retrocityransom/fami-fighter/media/photos/turbobox_presentation_small.jpg

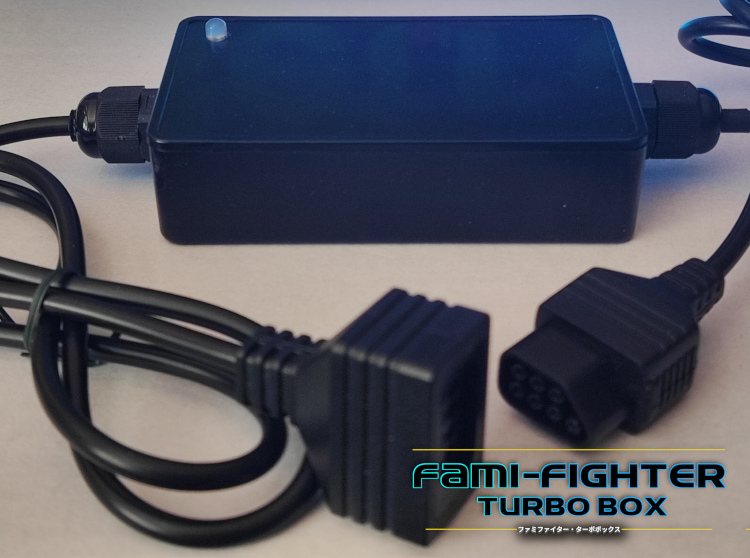
media/photos/turbobox_presentation_small.jpg
