retrocityransom/fami-fighter/files/Fami-Fighter_flashing_instructions_for_Arduino.pdf

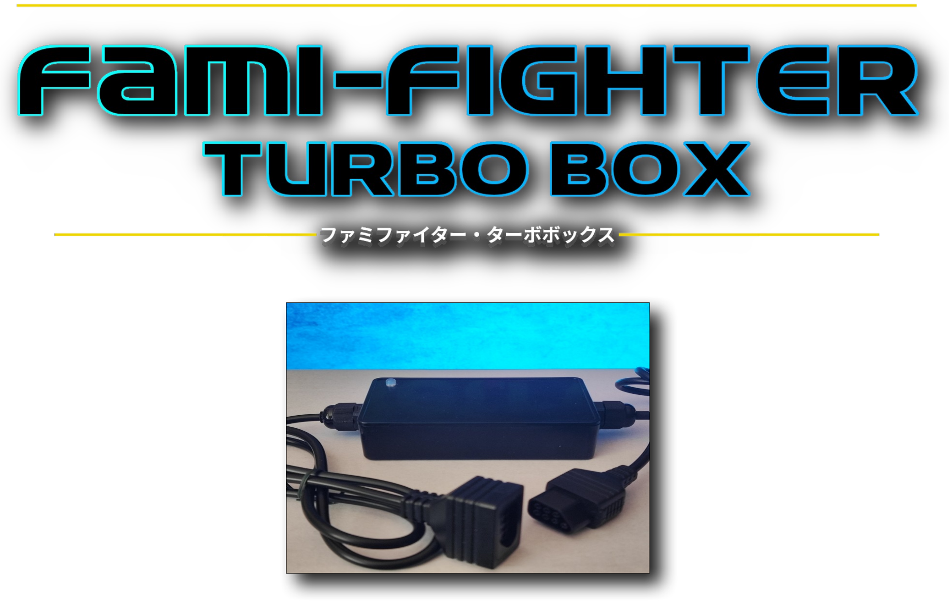
[picture p45: figure]

# Flashing Instructions for Arduino ver. 20260818

# Prerequisites

## - Download the code from https://github.com/retrocityransom/fami-fighter. (https://github.com/retrocityransom/fami-fighter)

## - Download and install the Arduino IDE from https://github.com/ard

uino/arduino-ide/releases/. (https://github.com/arduino/arduino-ide/releases/) It is free.

## - Get a USB-to-TTL adapter for the Arduino Pro Mini. It must support 5 V operation. The examples in this guide use an IDUINO

FT232.

## - Important: It is best to flash the code to the Arduino before installing it in the Turbo Box. However, you can flash updates or changes afterwards without any issues. Just make sure to disconnect your Turbo Box from your game console before

connecting it to the USB-to-TTL adapter.

# Step 1

Open the .ino script (“sketch“) from the code section that corresponds to the chosen hardware implementation variant. Currently, there is only one variant, but I plan to add a second one with an additional IC. Do not connect your USB-to-TTL adapter to your PC yet.

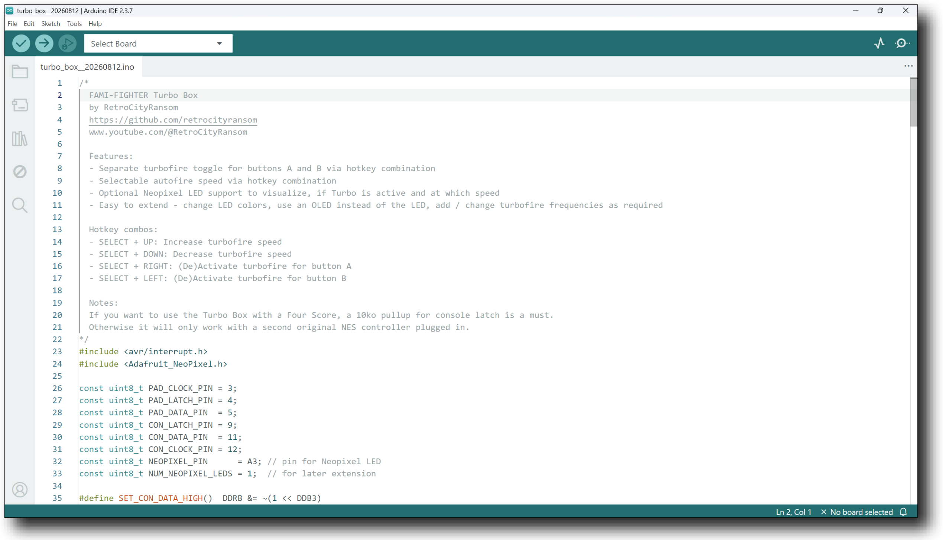
[picture p46: figure]

# Step 2

To install the required libraries, click the Library icon on the left-hand side.

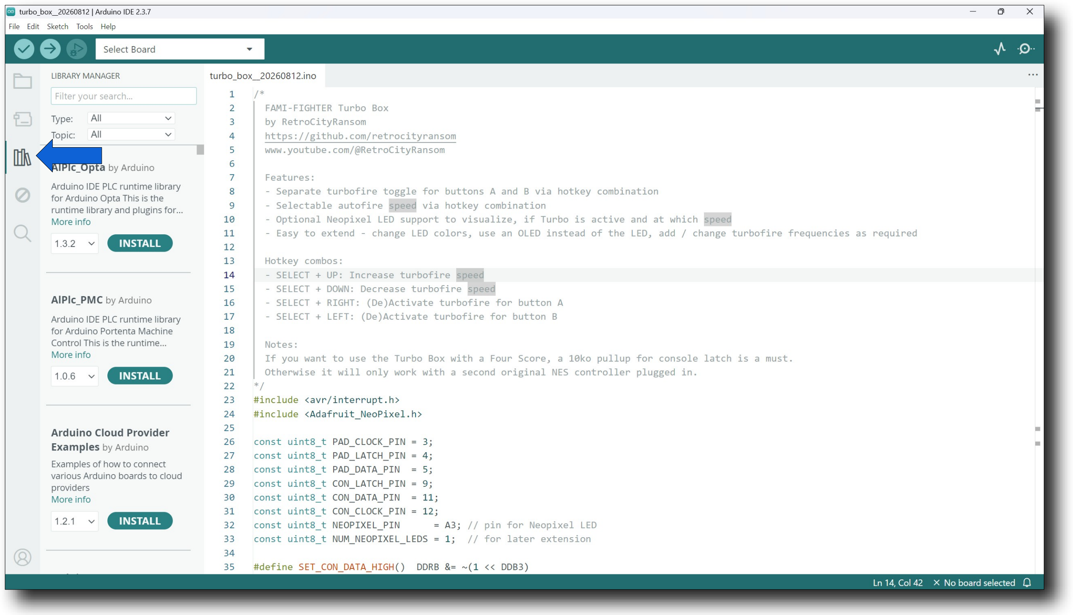
[picture p47: figure]

# Step 3

Search for and install the Adafruit NeoPixel library.

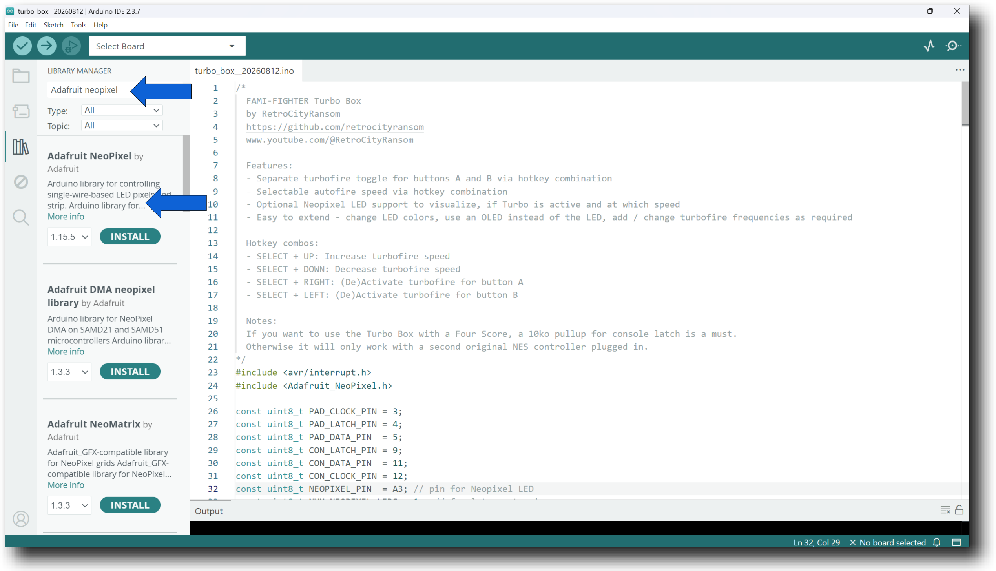
[picture p48: figure]

# Step 4

With the USB-to-TTL adapter still disconnected from your PC, click on “Select Board“ and note the COM port(s) shown. Once you connect your USB-to-TTL adapter via USB, an additional port should appear here.

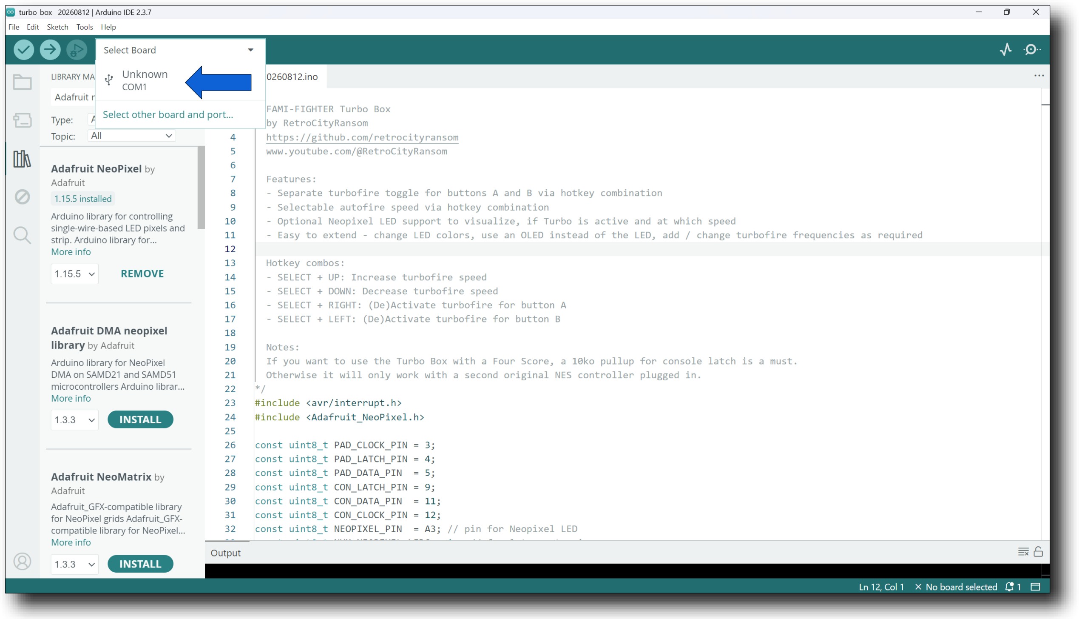
[picture p49: figure]

# Step 5

Set your USB-to-TTL adapter to 5 V and connect it to your PC.

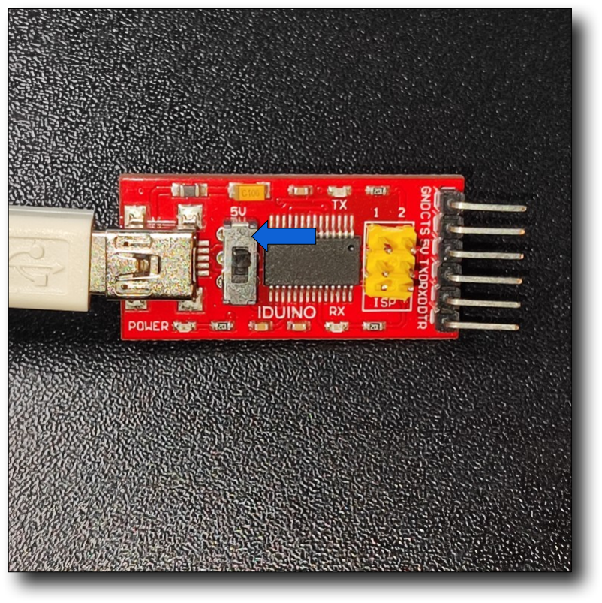
[picture p50: figure]

# Step 6

Now select the new port that appeared after connecting your USB-to-TTL adapter. In this example, it is COM4, but it may be different on your PC.

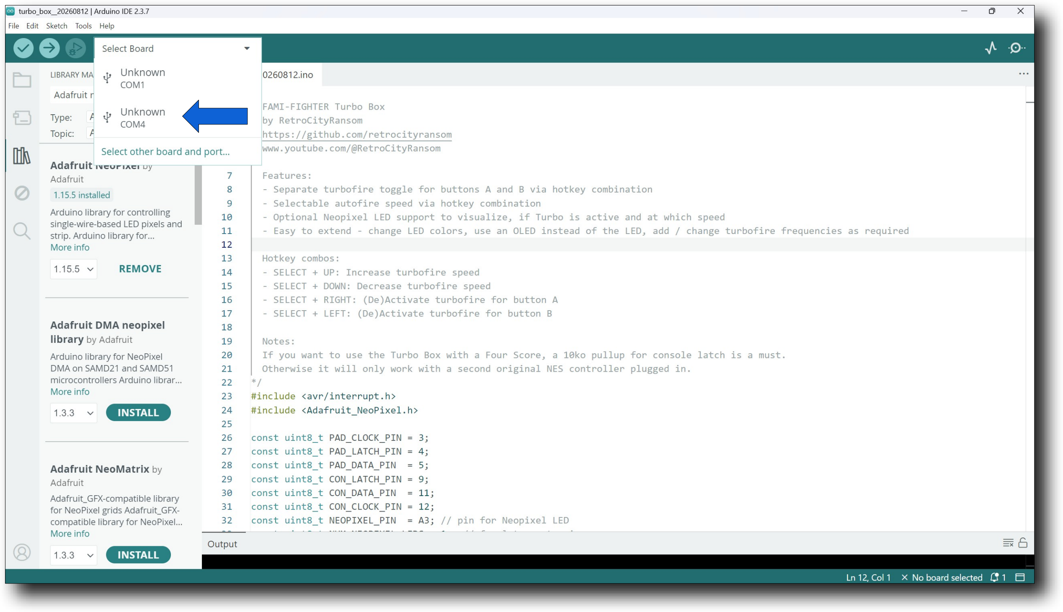
[picture p51: figure]

# Step 7

A new dialog for selecting your board will appear. Select the Arduino Pro Mini option and make sure that the port assigned to your USB-to-TTL adapter is correct.

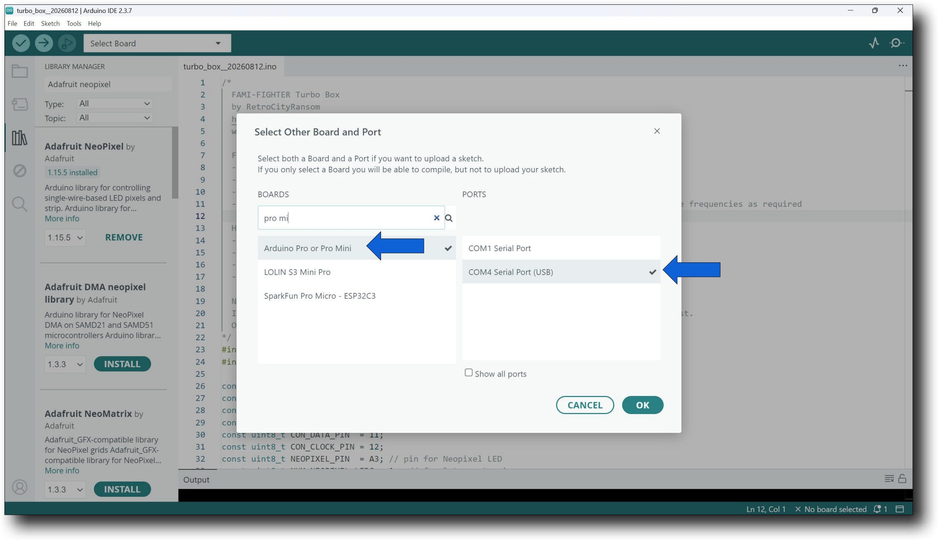
[picture p52: figure]

# Step 8

You can now optionally verify the code. Click the checkmark icon in the top-left corner. If the code is syntactically correct, all required libraries have been installed, and the code is compatible with your selected board, you will see a message saying “Done compiling.” in the bottom-right corner.

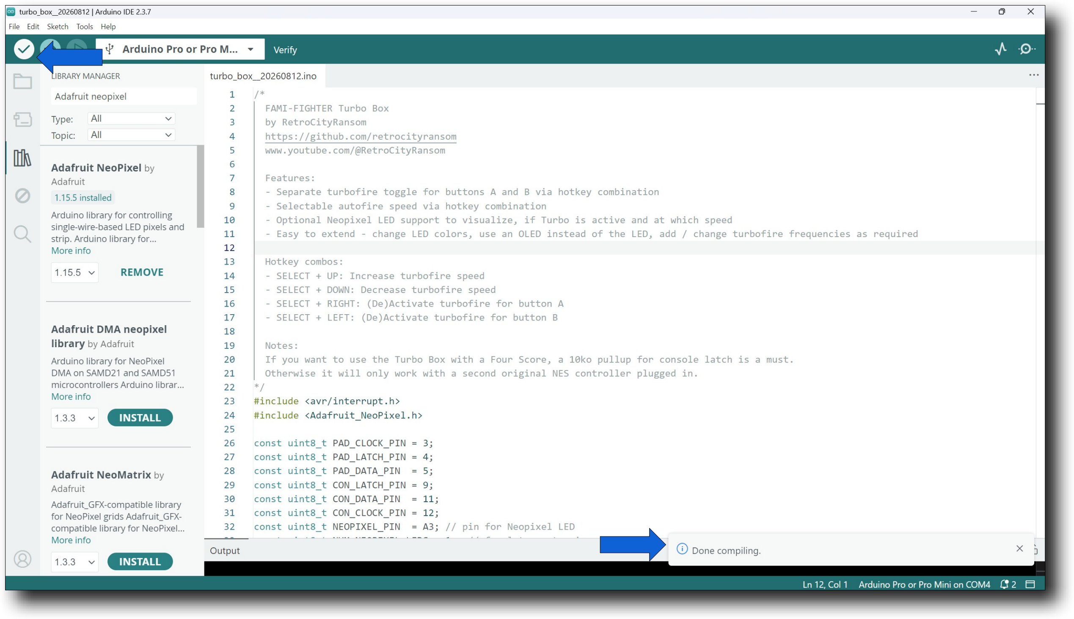
[picture p53: figure]

# Step 9

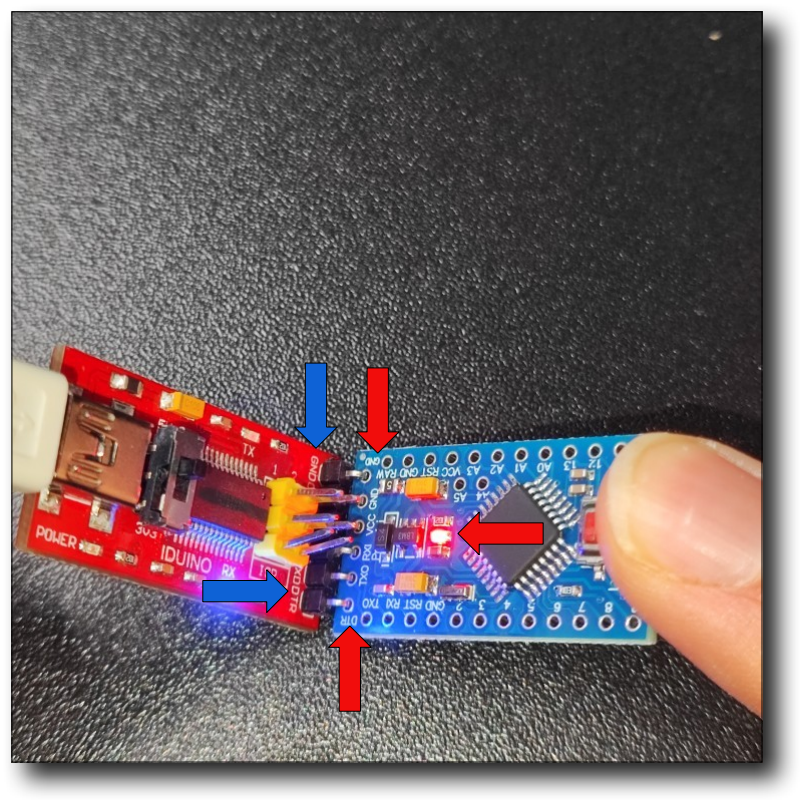
[picture p54: figure]

Now it is time to connect your USB-to-TTL adapter to the Arduino and flash the code. Make sure that you connect the GND and DTR pins of the Arduino to their corresponding pins on the adapter. The red LED in the middle of the Arduino board should light up. If it does not light up, or if another LED on the Arduino board starts flashing, try gently applying a little pressure between the two boards to ensure that the pins make proper contact.

# Step 10

Click the arrow icon to flash the code to the Arduino board. If your USB-to-TTL adapter is an IDUINO FT232, as shown in the example, two blue LEDs should start flashing during the programming process. The IDE will display a small notification in the bottom-right corner when the

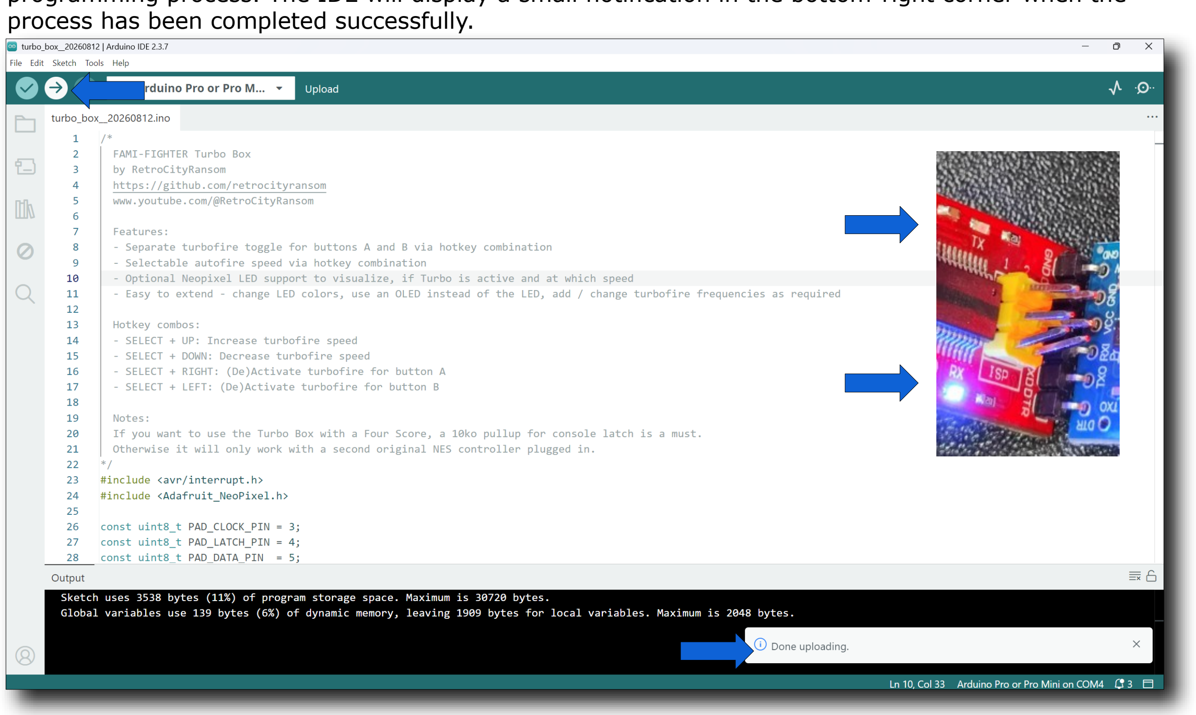
[picture p55: figure]
process has been completed successfully.

# - Code & diagrams: https://github.com/retrocityransom/fami-fighter - Trailer: https://youtu.be/9fGX9Tb3N7Q - Arduino IDE: https://github.com/arduino/arduino-ide/releases/

Your Arduino is now ready to go.

## Have lots of fun with it!
