retrocityransom/fami-fighter/(commit log)

2026-08-12 Fixes
    GFX Glitch fix
    Ghost buttons on startup fix
    Startropics fix
2026-08-19 Added Arduino howto guide
